tiberiutudorascu/Void/README.md

# Void
Robot Pet using an ESP32 w/ OLED screen
