tiberiutudorascu/Void/circuit.png

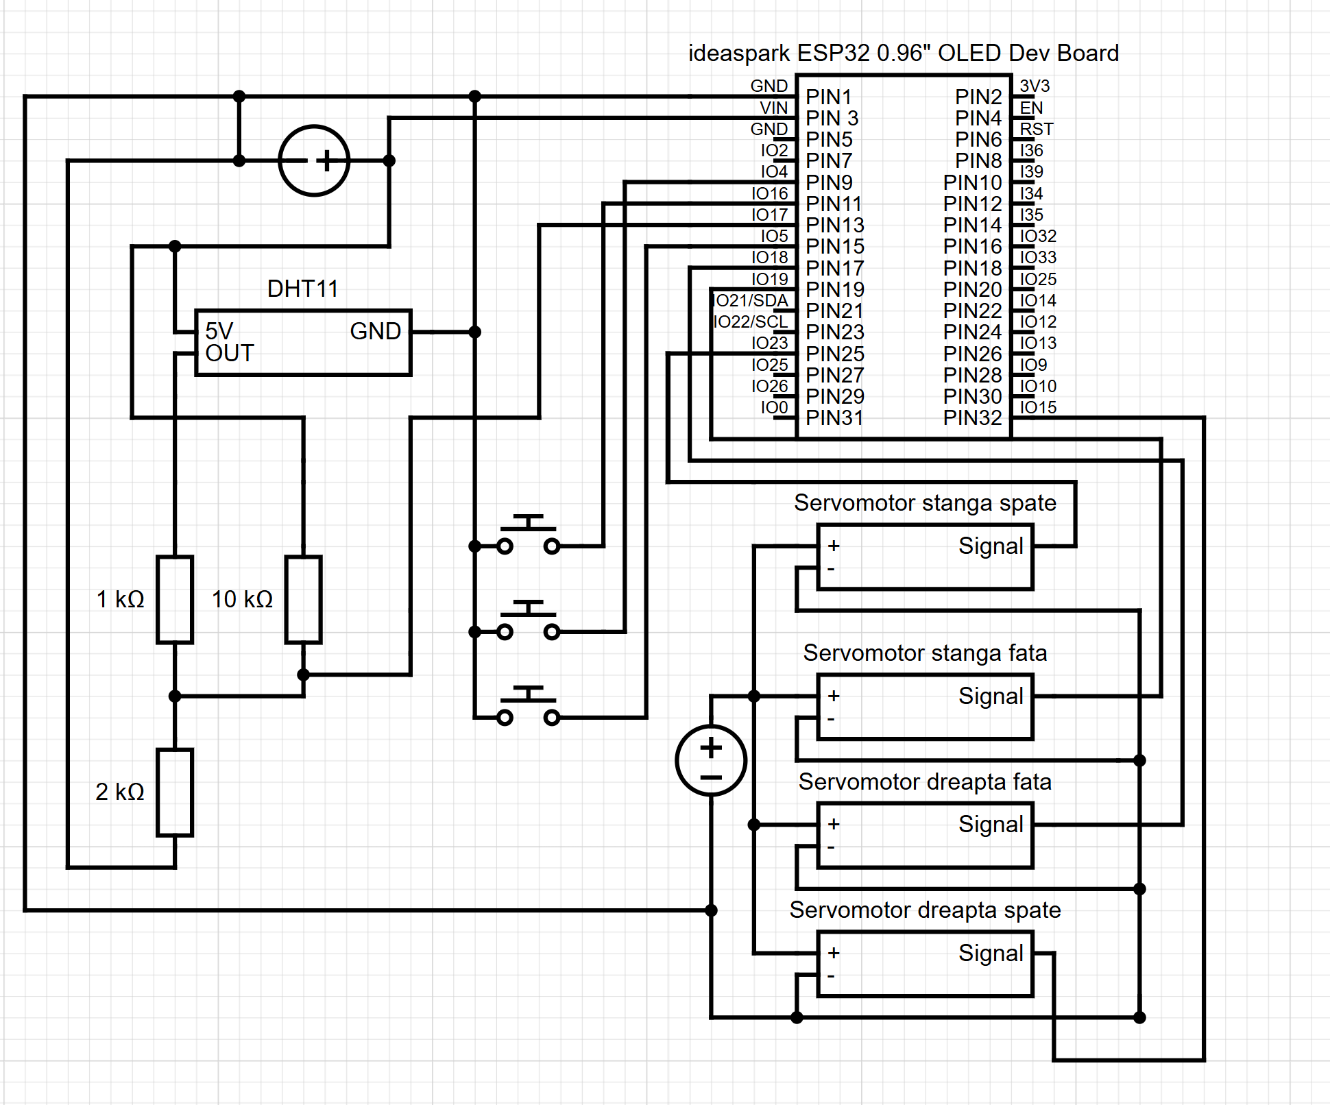
circuit.png
