tiberiutudorascu/Void/frames/trumpet.bmp

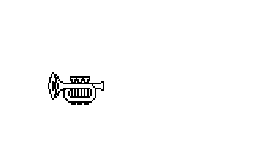
frames/trumpet.bmp
